usevolt/csb/doc/price_calc.md

### CSB price calculation 061117

				1 pcs	10 pcs	100 pcs
PWR SUPPLY
V40PW10CHM3/IGICT-ND		1.38	1.235	0.962
MC36211				0.082	0.082	0.0711
SMBJ33A				0.4	0.312	0.2139
T491D226K035AT			1.26	0.997	0.747
LM2671M-5.0/NOPB		3.55	3.19	2.615
744045210			0.74	0.72	0.669
MCP1700T-3302E/TT		0.34	0.28	0.25

LPC1549
LPC1549JBD64QL			6.62	5.98	4.95
