usevolt/csb/doc/ce_mark_csb.pdf

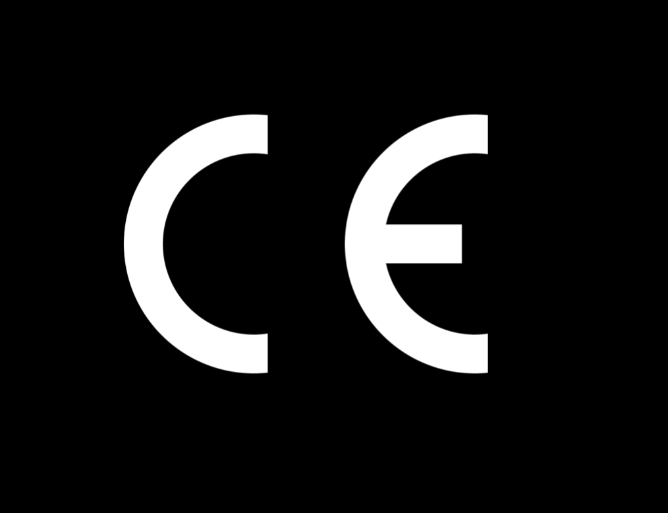
[picture p1: figure]

www.usewood.fi

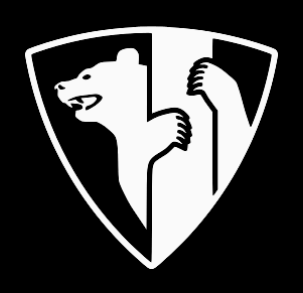
[picture p2: figure]

# Usewood CSB
