usevolt/csb/doc/ce_mark_csb_55x20mm.png

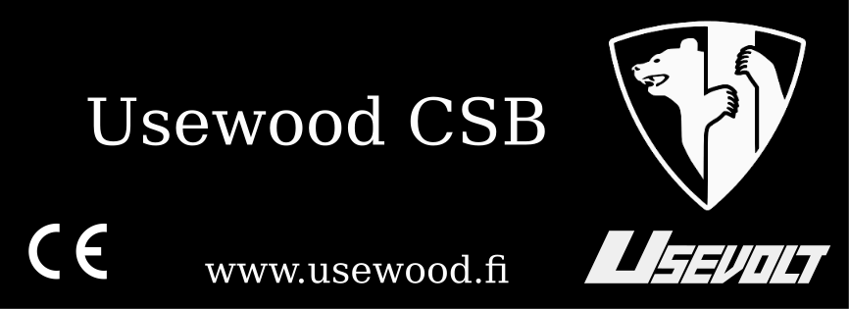
doc/ce_mark_csb_55x20mm.png
