usevolt/csb/hw/board_outline.dxf

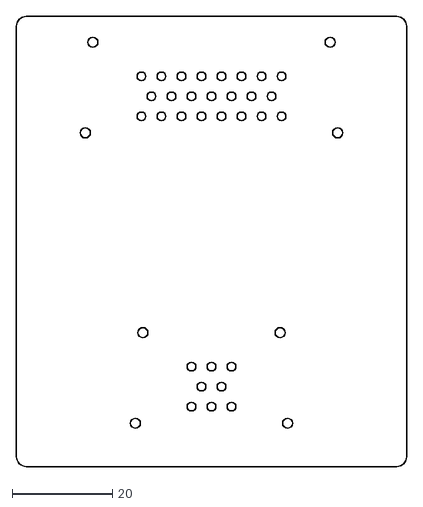
[picture p4: CAD file, 2018-10-14]
hw/board_outline.dxf
78.0 x 90.0
