usevolt/csb/hw/csb.kicad_pcb

## KiCad design hw/csb.kicad_pcb (2019-02-10)

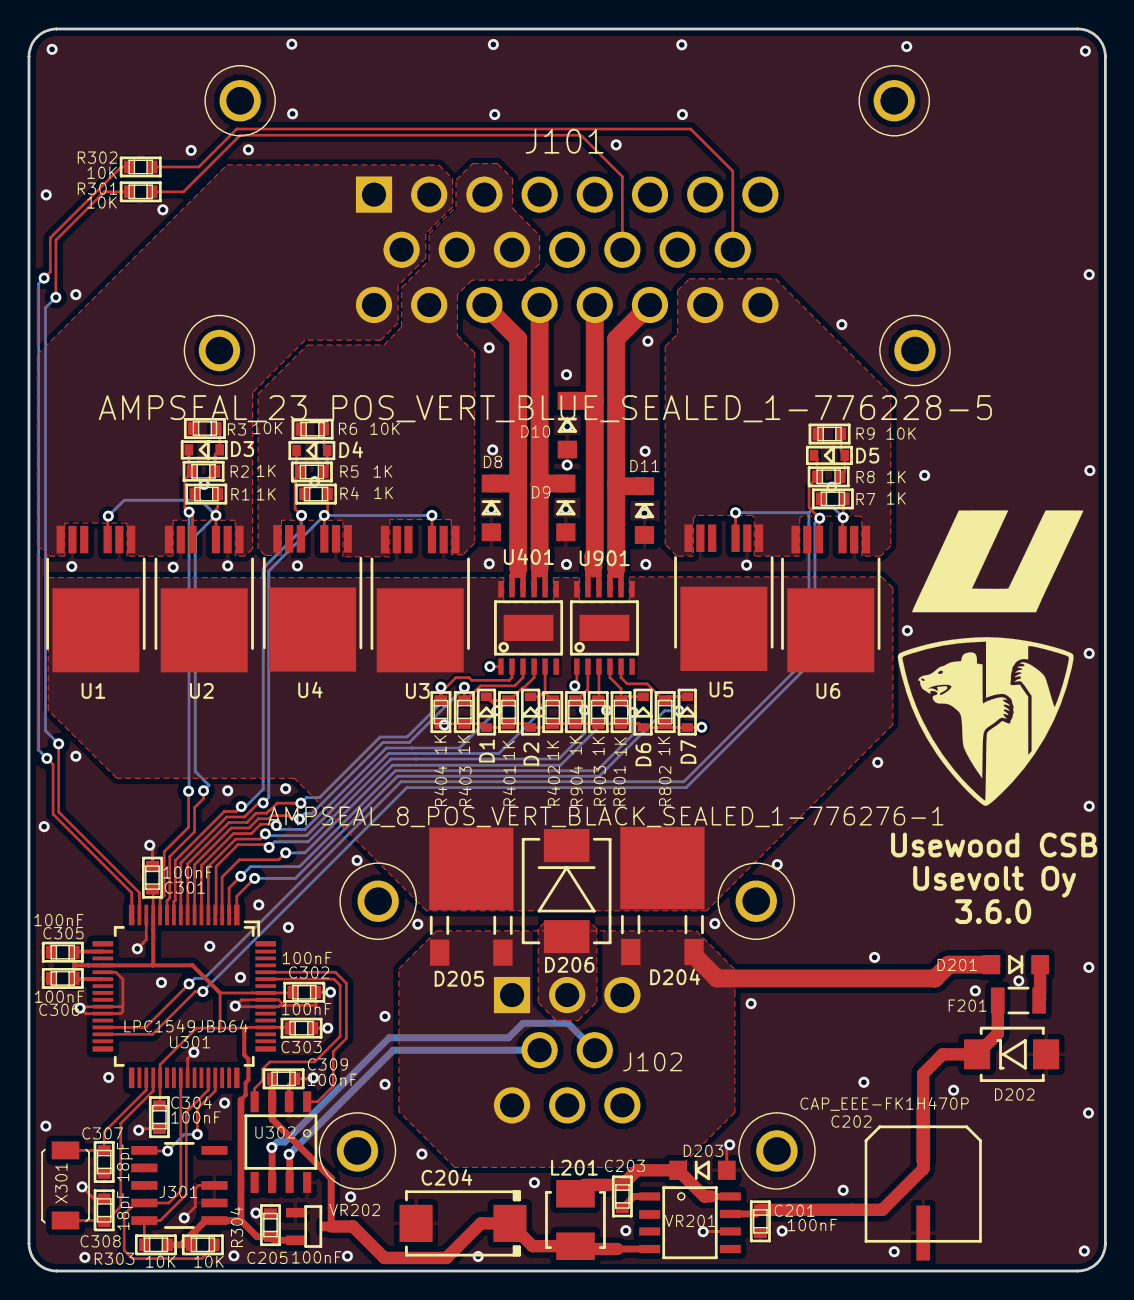
[picture p5: board csb.kicad_pcb from above]

Board: 2 copper layers, 78.0 x 90.0 mm, 70 parts (0 on the bottom side), 43 nets.

Parts:
C201, C205, C301, C302, C303, C304, C305, C306, C309: 100nF; 0603
C202: CAP_EEE-FK1H470P
C203: 10nF; 0603
C204: T491D226K035AT; 7343
C307, C308: 18pF; 0603
D1, D2, D3, D4, D5, D6, D7: ZENER_MM3Z3V6T1G; SOD-323
D8, D9, D10, D11, D201, D203: DIODE_RS07J-GS18; DO219AB
D202: DIODE_TVS_SMBJ33A-TRDO-214AA; DO-214AA
D204, D205: SCHOTTKY_DIODE_V40PW10C; SlimDPAK
D206: DIODE_TVS_TPSMD28A; DO-214AB
F201: FUSE_MC36211_350MA; FUSE_MC36211
J101: AMPSEAL_23_POS_VERT_BLUE_SEALED_1-776228-5; AMPSEAL_23_POS_776200-1
J102: AMPSEAL_8_POS_VERT_BLACK_SEALED_1-776276-1; AMPSEAL_8_POS_776275-1
J301: ARM_JTAG_SWD_HEADER_10_PINSMD; ARM_10_PIN_JTAG_SWD_CONNECTOR
L201: IND_744045210
R1, R2, R4, R5, R7, R8, R401, R402, R403, R404, R801, R802, R903, R904: 1K; 0603
R3, R6, R9, R301, R302, R303, R304: 10K; 0603
U1, U2, U3, U4, U5, U6: VN5E010AH; HPAK
U301: LPC1549JBD64; QFP64
U302: MCP2551_SOIC8; SOIC8
U401, U901: VND5050AJTR-E; PowerSSO-12
VR201: LM2671SOIC8; SOIC8
VR202: REG_MCP1700; SOT-23_3-PIN
X301: XTAL_7A-12.000MAAJ-T; XTAL_7A-20.000MAJ

Connections:
+3V3: C205.1, C301.1, C302.1, C303.1, C304.1, C305.1, C306.1, J301.P$1, R303.2, R304.2, U301.P$13, U301.P$18, U301.P$20, U301.P$22, U301.P$37, U301.P$52, U301.P$57, VR202.2
+5V: C204.+, C309.1, L201.2, U302.3, VR201.4, VR202.3
/BACK_4A: D9.P$2, J101.P$19, U401.8, U401.9
/BEACON_4A: D8.P$2, J101.P$18, U401.10, U401.11
/CANH: J102.P$4, U302.7
/CANL: J102.P$5, U302.6
/COOLER_30A: J101.P$22, J101.P$23, R9.2, U5.1, U5.7, U6.1, U6.7
/DRIVE_15A: J101.P$1, J101.P$2, J101.P$9, J101.P$16, R3.2, U1.1, U1.7, U2.1, U2.7
/IN_4A: D10.P$2, J101.P$20, U901.10, U901.11
/LPC1549/BACK: R403.2, U301.P$7, U401.3
/LPC1549/BACK_SENSE: D1.1, R401.1, U301.P$6, U401.4
/LPC1549/BEACON: R404.2, U301.P$8, U401.2
/LPC1549/BEACON_SENSE: D2.1, R402.1, U301.P$5, U401.5
/LPC1549/CAN_RX: U301.P$59, U302.4
/LPC1549/CAN_TX: U301.P$60, U302.1
/LPC1549/COOLER: R7.2, U5.3, U6.3, U301.P$29
/LPC1549/COOLER_P: J101.P$15, R302.1
/LPC1549/COOLER_SENSE: D5.1, R8.1, U6.5, U301.P$30
/LPC1549/DRIVE: R1.2, U1.3, U2.3, U301.P$11
/LPC1549/DRIVE_SENSE: D3.1, R2.1, U2.5, U301.P$12
/LPC1549/IN: R904.2, U301.P$4, U901.2
/LPC1549/IN_SENSE: D7.1, R802.1, U301.P$1, U901.5
/LPC1549/RESET: J301.P$9, U301.P$45
/LPC1549/WIPER_POS: J101.P$13, R301.1
/Power Supply/VIN: D201.P$1, D204.1, D204.2, D205.1, D205.2, J102.P$1, J102.P$3, J102.P$6
/Sheet5A02A41E/IN1: R903.2, U301.P$3, U901.3
/Sheet5A02A41E/SENSE1: D6.1, R801.1, U301.P$2, U901.4
/Sheet5A019745/IN1: R4.2, U3.3, U4.3, U301.P$9
/Sheet5A019745/SENSE1: D4.1, R5.1, U4.5, U301.P$10
/WIPER_4A: D11.P$2, J101.P$21, U901.8, U901.9
/WORK_15A: J101.P$3, J101.P$10, J101.P$11, J101.P$17, R6.2, U3.1, U3.7, U4.1, U4.7
GND: C201.2, C202.-, C204.-, C205.2, C301.2, C302.2, C303.2, C304.2, C305.2, C306.2, C307.2, C308.2, C309.2, D1.2, D2.2, D3.2, D4.2, D5.2, D6.2, D7.2, D8.P$1, D9.P$1, D10.P$1, D11.P$1, D202.P$1, D203.P$1, D206.1, J102.P$2, J301.P$3, J301.P$5, R1.1, R2.2, R3.1, R4.1, R5.2, R6.1, R7.1, R8.2, R9.1, R401.2, R402.2, R403.1, R404.1, R801.2, R802.2, R903.1, R904.1, U1.2, U1.6, U2.2, U2.6, U3.2, U3.6, U4.2, U4.6, U5.2, U5.6, U6.2, U6.6, U301.P$14, U301.P$21, U301.P$26, U301.P$27, U301.P$41, U301.P$55, U301.P$56, U302.2, U302.8, U401.1, U901.1, VR201.6, VR202.1
unnamed: C201.1, C202.+, D202.P$2, F201.P$2, VR201.7
unnamed: C203.1, VR201.1
unnamed: C203.2, D203.P$2, L201.1, VR201.8
unnamed: C307.1, U301.P$35, X301.P$1
unnamed: C308.1, U301.P$36, X301.P$2
unnamed: D201.P$2, F201.P$1
unnamed: J301.P$2, R303.1, U301.P$44
unnamed: J301.P$4, R304.1, U301.P$40
unnamed: R301.2, U301.P$15
unnamed: R302.2, U301.P$16
VDD: D204.3, D205.3, D206.2, U1.4, U2.4, U3.4, U4.4, U5.4, U6.4, U401.7, U401.12, U401.13, U901.7, U901.12, U901.13
