usevolt/csb/sw/src/messages.c

/*
 * uw_messages.c
 *
 *  Created on: Feb 19, 2015
 *      Author: usenius
 */


#include "main.h"
#include "messages.h"
#include "pin_mappings.h"
#include <stdlib.h>
#include <stdio.h>
#include <string.h>
#include <uv_timer.h>
#include <uv_utilities.h>
#include <uv_rtos.h>

extern dev_st dev;


void drivel_callb(void *me, unsigned int cmd, unsigned int args, argument_st *argv);
void workl_callb(void *me, unsigned int cmd, unsigned int args, argument_st *argv);
void backl_callb(void *me, unsigned int cmd, unsigned int args, argument_st *argv);
void inl_callb(void *me, unsigned int cmd, unsigned int args, argument_st *argv);
void beacon_callb(void *me, unsigned int cmd, unsigned int args, argument_st *argv);
void wiper_callb(void *me, unsigned int cmd, unsigned int args, argument_st *argv);
void cooler_callb(void *me, unsigned int cmd, unsigned int args, argument_st *argv);
void oilcooler_callb(void *me, unsigned int cmd, unsigned int args, argument_st *argv);
void oilc_callb(void *me, unsigned int cmd, unsigned int args, argument_st *argv);
void stat_callb(void *me, unsigned int cmd, unsigned int args, argument_st *argv);


canopen_object_st obj_dict[] = {
		{
				.main_index = CSB_TOTAL_CURRENT_INDEX,
				.sub_index = CSB_TOTAL_CURRENT_SUBINDEX,
				.type = CSB_TOTAL_CURRENT_TYPE,
				.permissions = CSB_TOTAL_CURRENT_PERMISSIONS,
				.data_ptr = &dev.total_current
		},
		{
				.main_index = CSB_WORK_LIGHT_STATUS_INDEX,
				.sub_index = CSB_WORK_LIGHT_STATUS_SUBINDEX,
				.type = CSB_WORK_LIGHT_STATUS_TYPE,
				.permissions = CSB_WORK_LIGHT_STATUS_PERMISSIONS,
				.data_ptr = &dev.work_light.state
		},
		{
				.main_index = CSB_WORK_LIGHT_CURRENT_INDEX,
				.sub_index = CSB_WORK_LIGHT_CURRENT_SUBINDEX,
				.type = CSB_WORK_LIGHT_CURRENT_TYPE,
				.permissions = CSB_WORK_LIGHT_CURRENT_PERMISSIONS,
				.data_ptr = &dev.work_light.current
		},
		{
				.main_index = CSB_DRIVE_LIGHT_STATUS_INDEX,
				.sub_index = CSB_DRIVE_LIGHT_STATUS_SUBINDEX,
				.type = CSB_DRIVE_LIGHT_STATUS_TYPE,
				.permissions = CSB_DRIVE_LIGHT_STATUS_PERMISSIONS,
				.data_ptr = &dev.drive_light.state
		},
		{
				.main_index = CSB_DRIVE_LIGHT_CURRENT_INDEX,
				.sub_index = CSB_DRIVE_LIGHT_CURRENT_SUBINDEX,
				.type = CSB_DRIVE_LIGHT_CURRENT_TYPE,
				.permissions = CSB_DRIVE_LIGHT_CURRENT_PERMISSIONS,
				.data_ptr = &dev.drive_light.current
		},
		{
				.main_index = CSB_BACK_LIGHT_STATUS_INDEX,
				.sub_index = CSB_BACK_LIGHT_STATUS_SUBINDEX,
				.type = CSB_BACK_LIGHT_STATUS_TYPE,
				.permissions = CSB_BACK_LIGHT_STATUS_PERMISSIONS,
				.data_ptr = &dev.back_light.state
		},
		{
				.main_index = CSB_BACK_LIGHT_CURRENT_INDEX,
				.sub_index = CSB_BACK_LIGHT_CURRENT_SUBINDEX,
				.type = CSB_BACK_LIGHT_CURRENT_TYPE,
				.permissions = CSB_BACK_LIGHT_CURRENT_PERMISSIONS,
				.data_ptr = &dev.back_light.current
		},
		{
				.main_index = CSB_IN_LIGHT_STATUS_INDEX,
				.sub_index = CSB_IN_LIGHT_STATUS_SUBINDEX,
				.type = CSB_IN_LIGHT_STATUS_TYPE,
				.permissions = CSB_IN_LIGHT_STATUS_PERMISSIONS,
				.data_ptr = &dev.in_light.state
		},
		{
				.main_index = CSB_IN_LIGHT_CURRENT_INDEX,
				.sub_index = CSB_IN_LIGHT_CURRENT_SUBINDEX,
				.type = CSB_IN_LIGHT_CURRENT_TYPE,
				.permissions = CSB_IN_LIGHT_CURRENT_PERMISSIONS,
				.data_ptr = &dev.in_light.current
		},
		{
				.main_index = CSB_BEACON_STATUS_INDEX,
				.sub_index = CSB_BEACON_STATUS_SUBINDEX,
				.type = CSB_BEACON_STATUS_TYPE,
				.permissions = CSB_BEACON_STATUS_PERMISSIONS,
				.data_ptr = &dev.beacon.state
		},
		{
				.main_index = CSB_BEACON_CURRENT_INDEX,
				.sub_index = CSB_BEACON_CURRENT_SUBINDEX,
				.type = CSB_BEACON_CURRENT_TYPE,
				.permissions = CSB_BEACON_CURRENT_PERMISSIONS,
				.data_ptr = &dev.beacon.current
		},
		{
				.main_index = CSB_BEACON_ENABLED_INDEX,
				.sub_index = CSB_BEACON_ENABLED_SUBINDEX,
				.type = CSB_BEACON_ENABLED_TYPE,
				.permissions = CSB_BEACON_ENABLED_PERMISSIONS,
				.data_ptr = &dev.beacon_enabled
		},
		{
				.main_index = CSB_WIPER_STATUS_INDEX,
				.sub_index = CSB_WIPER_STATUS_SUBINDEX,
				.type = CSB_WIPER_STATUS_TYPE,
				.permissions = CSB_WIPER_STATUS_PERMISSIONS,
				.data_ptr = &dev.wiper.state
		},
		{
				.main_index = CSB_WIPER_CURRENT_INDEX,
				.sub_index = CSB_WIPER_CURRENT_SUBINDEX,
				.type = CSB_WIPER_CURRENT_TYPE,
				.permissions = CSB_WIPER_CURRENT_PERMISSIONS,
				.data_ptr = &dev.wiper.current
		},
		{
				.main_index = CSB_WIPER_SPEED_INDEX,
				.sub_index = CSB_WIPER_SPEED_SUBINDEX,
				.type = CSB_WIPER_SPEED_TYPE,
				.permissions = CSB_WIPER_SPEED_PERMISSIONS,
				.data_ptr = &dev.wiper_speed
		},
		{
				.main_index = CSB_WIPER_REQ_INDEX,
				.sub_index = CSB_WIPER_REQ_SUBINDEX,
				.type = CSB_WIPER_REQ_TYPE,
				.permissions = CSB_WIPER_REQ_PERMISSIONS,
				.data_ptr = &dev.wiper_req
		},
		{
				.main_index = CSB_WIPER_POL_INDEX,
				.sub_index = CSB_WIPER_POL_SUBINDEX,
				.type = CSB_WIPER_POL_TYPE,
				.permissions = CSB_WIPER_POL_PERMISSIONS,
				.data_ptr = &dev.wiper_pol
		},
		{
				.main_index = CSB_WIPER_MANUAL_INDEX,
				.sub_index = CSB_WIPER_MANUAL_SUBINDEX,
				.type = CSB_WIPER_MANUAL_TYPE,
				.permissions = CSB_WIPER_MANUAL_PERMISSIONS,
				.data_ptr = &dev.wiper_manual
		},
		{
				.main_index = CSB_COOLER_STATUS_INDEX,
				.sub_index = CSB_COOLER_STATUS_SUBINDEX,
				.type = CSB_COOLER_STATUS_TYPE,
				.permissions = CSB_COOLER_STATUS_PERMISSIONS,
				.data_ptr = &dev.cooler.state
		},
		{
				.main_index = CSB_COOLER_CURRENT_INDEX,
				.sub_index = CSB_COOLER_CURRENT_SUBINDEX,
				.type = CSB_COOLER_CURRENT_TYPE,
				.permissions = CSB_COOLER_CURRENT_PERMISSIONS,
				.data_ptr = &dev.cooler.current
		},
		{
				.main_index = CSB_COOLER_P_INDEX,
				.sub_index = CSB_COOLER_P_SUBINDEX,
				.type = CSB_COOLER_P_TYPE,
				.permissions = CSB_COOLER_P_PERMISSIONS,
				.data_ptr = &dev.cooler_p
		},
		{
				.main_index = CSB_FSB_INDEX_OFFSET + FSB_IGNKEY_INDEX,
				.sub_index = FSB_IGNKEY_SUBINDEX,
				.type = FSB_IGNKEY_TYPE,
				.permissions = FSB_IGNKEY_PERMISSIONS,
				.data_ptr = &dev.fsb.ignkey
		},
		{
				.main_index = CSB_FSB_INDEX_OFFSET + FSB_EMCY_INDEX,
				.sub_index = FSB_EMCY_SUBINDEX,
				.type = FSB_EMCY_TYPE,
				.permissions = FSB_EMCY_PERMISSIONS,
				.data_ptr = &dev.fsb.emcy
		},
		{
				.main_index = CSB_FSB_INDEX_OFFSET + FSB_DOORSW1_INDEX,
				.sub_index = FSB_DOORSW1_SUBINDEX,
				.type = FSB_DOORSW1_TYPE,
				.permissions = FSB_DOORSW1_PERMISSIONS,
				.data_ptr = &dev.fsb.door_sw1
		},
		{
				.main_index = CSB_FSB_INDEX_OFFSET + FSB_DOORSW2_INDEX,
				.sub_index = FSB_DOORSW2_SUBINDEX,
				.type = FSB_DOORSW2_TYPE,
				.permissions = FSB_DOORSW2_PERMISSIONS,
				.data_ptr = &dev.fsb.door_sw2
		},
		{
				.main_index = CSB_FSB_INDEX_OFFSET + FSB_SEATSW_INDEX,
				.sub_index = FSB_SEATSW_SUBINDEX,
				.type = FSB_SEATSW_TYPE,
				.permissions = FSB_SEATSW_PERMISSIONS,
				.data_ptr = &dev.fsb.seat_sw
		}

};

int obj_dict_len() {
	return sizeof(obj_dict) / sizeof(canopen_object_st);
}



const uv_command_st terminal_commands[] = {
		{
				.id = CMD_DRIVE_LIGHT,
				.str = "drivel",
				.instructions = "Sets the drive light output state.\n"
						"Usage: drivel (1/0)",
				.callback = &drivel_callb
		},
		{
				.id = CMD_WORK_LIGHT,
				.str = "workl",
				.instructions = "Sets the work light output state.\n"
						"Usage: qorkl (1/0)",
				.callback = &workl_callb
		},
		{
				.id = CMD_BACK_LIGHT,
				.str = "backl",
				.instructions = "Sets the back light output state.\n"
						"Usage: backl (1/0)",
				.callback = &backl_callb
		},
		{
				.id = CMD_IN_LIGHT,
				.str = "inl",
				.instructions = "Sets the in light output state.\n"
						"Usage: inl (1/0)",
				.callback = &inl_callb
		},
		{
				.id = CMD_BEACON,
				.str = "beacon",
				.instructions = "Sets the beacon output state.\n"
						"Usage: beacon (1/0)",
				.callback = &beacon_callb
		},
		{
				.id = CMD_WIPER,
				.str = "wiper",
				.instructions = "Sets the wiper speed. Can also be used to set \n"
						"the wiper home position polarity, or set wiper to be working as an\n"
						"manual wiper.\n"
						"Usage: wiper (\"pol\"/\"man\"/0...100) (value)",
				.callback = &wiper_callb
		},
		{
				.id = CMD_COOLER,
				.str = "cooler",
				.instructions = "Sets the cooler output state.\n"
						"Usage: cooler (1/0)",
				.callback = &cooler_callb
		},
		{
				.id = CMD_STAT,
				.str = "stat",
				.instructions = "Shows system status\n"
						"Usage: stat",
				.callback = &stat_callb
		}
};




unsigned int commands_size(void) {
	return sizeof(terminal_commands) / sizeof(uv_command_st);
}




#define this ((dev_st*)me)




void drivel_callb(void *me, unsigned int cmd, unsigned int args, argument_st *argv) {
	if (args) {
		uv_output_set_state(&this->drive_light,
				(argv[0].number) ? OUTPUT_STATE_ON : OUTPUT_STATE_OFF);
	}
	printf("drive light state: %u, current: %i\n", this->drive_light.state,
			(unsigned int) this->drive_light.current);
}

void workl_callb(void *me, unsigned int cmd, unsigned int args, argument_st *argv) {
	if (args) {
		uv_output_set_state(&this->work_light,
				(argv[0].number) ? OUTPUT_STATE_ON : OUTPUT_STATE_OFF);
	}
	printf("work light state: %u, current: %i\n", this->work_light.state,
			(unsigned int) this->work_light.current);
}

void backl_callb(void *me, unsigned int cmd, unsigned int args, argument_st *argv) {
	if (args) {
		uv_output_set_state(&this->back_light,
				(argv[0].number) ? OUTPUT_STATE_ON : OUTPUT_STATE_OFF);
	}
	printf("back light state: %u, current: %i\n", this->back_light.state,
			(unsigned int) this->back_light.current);
}

void inl_callb(void *me, unsigned int cmd, unsigned int args, argument_st *argv) {
	if (args) {
		uv_output_set_state(&this->in_light,
				(argv[0].number) ? OUTPUT_STATE_ON : OUTPUT_STATE_OFF);
	}
	printf("in light state: %u, current: %i\n", this->in_light.state,
			(unsigned int) this->in_light.current);
}

void beacon_callb(void *me, unsigned int cmd, unsigned int args, argument_st *argv) {
	if (args) {
		uv_output_set_state(&this->beacon,
				(argv[0].number) ? OUTPUT_STATE_ON : OUTPUT_STATE_OFF);
	}
	printf("beacon light state: %u, current: %i\n", this->beacon.state,
			(unsigned int) this->beacon.current);
}

void wiper_callb(void *me, unsigned int cmd, unsigned int args, argument_st *argv) {
	if (args) {
		if (argv[0].type == ARG_INTEGER) {
			this->wiper_speed = argv[0].number;
		}
		else {
			if (strcmp(argv[0].str, "pol") == 0) {
				if (args >= 2) {
					if (argv[1].type == ARG_INTEGER) {
						this->wiper_pol = argv[1].number;
					}
					else {
						printf("Wiper polarity has to be integer\n");
					}
				}
			}
			else if (strcmp(argv[0].str, "man") == 0) {
				if (args >= 2) {
					this->wiper_manual = argv[1].number ? true : false;
				}
			}
			else {
				printf("Unknown wiper command '%s'\n", argv[0].str);
			}
		}
	}
	printf("wiper state: %u, current: %i, speed: %u polarity: %u manual: %u\n", this->wiper.state,
			(unsigned int) this->wiper.current, this->wiper_speed, this->wiper_pol, this->wiper_manual);
}

void cooler_callb(void *me, unsigned int cmd, unsigned int args, argument_st *argv) {
	if (args) {
		uv_output_set_state(&this->cooler,
				(argv[0].number) ? OUTPUT_STATE_ON : OUTPUT_STATE_OFF);
	}
	printf("cooler state: %u, current: %i\n", this->cooler.state,
			(unsigned int) this->cooler.current);
}



static void stat_output(uv_output_st *output, const char *output_name) {
	printf("%s state: %u, current: %u mA, adc: 0x%x / 0x%x\n",
			output_name, uv_output_get_state(output), uv_output_get_current(output),
			uv_adc_read(output->adc_chn), ADC_MAX_VALUE);
}

void stat_callb(void *me, unsigned int cmd, unsigned int args, argument_st *argv) {
	printf("SYSTEM STATUS:\n");
	printf("Total current: %u mA\n", (unsigned int) this->total_current);
	stat_output(&this->work_light, "Work Light");
	stat_output(&this->drive_light, "Drive Light");
	stat_output(&this->back_light, "Back Light");
	stat_output(&this->in_light, "In Light");
	stat_output(&this->beacon, "Beacon");
	stat_output(&this->cooler, "Cooler");
	stat_output(&this->wiper, "Wiper");

	printf("Wiper speed: %i\nWiper pos: %u\nCooler P: %i\n"
			"Beacon enabled: %i\nESB \n",
			this->wiper_speed, uv_gpio_get(WIPER_SENSOR_IO),
			this->cooler_p, this->beacon_enabled);
}
