usevolt/csb/(commit log)

2017-06-28 Started designing CSB board
    [LT1161.sch, LT1161_2.sch, csb.kicad_pcb, csb.sch, currentSense.sch, lpc1549.sch, pwr_supply_sheet.sch]
2017-07-03 first pcb revision ready to order
    [LT1161.sch, LT1161_2.sch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]
2017-08-03 sw directory created, oil cooler added in hw
    [LT1161.sch, LT1161_2.sch, csb.kicad_pcb, csb.sch, currentSense.sch, lpc1549.sch, pwr_supply_sheet.sch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]
2017-08-11 ready for testing in real machine for first time
    [LT1161.sch, csb.sch, currentSense.sch, lpc1549.sch]
2017-08-14 revision 2.0.0 pcb ready to order
    [csb.kicad_pcb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]
2017-09-05 at least shortcirucuit protection works
    [LT1161.sch, LT1161_2.sch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]
2017-10-19 starting to draw version 4.0.0
    [LT1161.sch, LT1161_2.sch, csb.kicad_pcb, csb.sch, currentSense.sch, currentSense2.sch, currentSense3.sch, lpc1549.sch]
2017-10-19 all outputs tested with multimeter, wiper logic still missing
    [main.c, main.h, messages.c, messages.h, pin_mappings.h]
2017-11-16 3.1.0 hw created, not yet ordered
    [LT1161.sch, LT1161_2.sch, bts6133d.sch, csb.kicad_pcb, csb.sch, currentSense.sch, currentSense2.sch, currentSense3.sch]
2017-11-18 3.1.0 gerber created for seeed studios
    [csb-B.Cu.gbl, csb-B.Mask.gbs, csb-B.SilkS.gbo, csb-Edge.Cuts.gm1, csb-F.Cu.gtl, csb-F.Mask.gts, csb-F.SilkS.gto, csb.drl]
2017-11-20 oil cooler removed, 3.2.0 ready to order
    [bts6133d.sch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]
2017-12-19 hw 3.3 created
    [csb.kicad_pcb, csb.sch, vn5e010ah.sch, vnd5050.sch]
2017-12-19 hw 3.3.0 ordered from seeed
    [csb-B.Cu.gbl, csb-B.Mask.gbs, csb-B.SilkS.gbo, csb-Edge.Cuts.gm1, csb-F.Cu.gtl, csb-F.Mask.gts, csb-F.SilkS.gto, csb.drl]
2018-02-05 working revision FM_6.6.1
    [csb.kicad_pcb, csb.sch, lpc1549.sch]
2018-04-07 wiper 1 time wiping bug fix
    [main.c, main.h]
2018-06-05 cooler max current set to 30A
2018-08-15 making modifications to pcb...
    [csb-2018-06-09-18-47-28.sch, csb.kicad_pcb, csb.sch, lpc1549-2018-06-09-18-47-28.sch, lpc1549.sch, pwr_supply_sheet-2018-06-09-18-47-28.sch, pwr_supply_sheet.sch, vn5e010ah-2018-06-09-18-47-28.sch]
2018-09-09 bug fix: back light is controlled by drive ligths
    [main.c, main.h, messages.c]
2018-09-18 cooler and wiper is stopper if ignkey is off for too long
    [main.c, main.h, messages.c]
2018-09-18 fsb seat switch obj dict entry added
2018-10-14 Drawing pcb 4.0.0
    [board_outline.dxf, csb.kicad_pcb, vn5e010ah.sch, vn5e010ah_double.sch, vnd5050.sch]
2018-11-27 work & drive light max current increased to 20 A
2018-11-28 pcb 3.4.0 created, ready for order
    [csb.kicad_pcb, lpc1549.sch]
2018-12-21 3.4.0 gerber files generated
    [csb-B.Cu.gbl, csb-B.Mask.gbs, csb-B.SilkS.gbo, csb-Edge.Cuts.gm1, csb-F.Cu.gtl, csb-F.Paste.gtp, csb-F.SilkS.gto, csb-NPTH.drl]
2019-01-21 pin mappings updated for hw 3.4.0
2019-01-29 CAP moved away from AMPSEAL leg
    [csb.kicad_pcb]
2019-01-29 pcb 3.5.0 created, added protection diodes for vnd4040 outputs
    [_saved_csb.sch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]
2019-01-29 silkscreen updated for 3.5.0
    [_saved_csb.sch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]
2019-02-10 pcb 3.6.0 created, with double fets in work & drive lights
    [csb-B.Cu.gbl, csb-B.Mask.gbs, csb-B.SilkS.gbo, csb-Edge.Cuts.gm1, csb-F.Cu.gtl, csb-F.Mask.gts, csb-F.Paste.gtp, csb-F.SilkS.gto]
2019-02-25 vnd5050 current amp multiplier updated for 1k resistors
2019-03-14 HAL update for small bugfixes
    [main.c]
2019-03-16 new mode for wiper (from tammekivi) delay based button pressing
